unemployable/Golf-Mk5-RCD330-CAN-Filter/Ghidra/README.md

# Golf Mk5 RCD330 CAN Filter - Ghidra Reverse Engineering Files #
## Chinese CAN Filter Black Box ##

These devices only seem to be available as part of an adapter cable.<BR>
I've found at least two versions, with only minor differences in the code.

Included files are an original dumped binary, Ghidra zip file (gzf) & an export of the decompiled 'C' code.
  
It makes use of Thomas Roth's excellent Ghidra SVD-Loader scripts.

This is my first, amateur attempt to decompile an STM32 binary.<BR>
I have tried to include lots of comments to assist with my understanding of the code.

The most interesting function is the CAN interrupt routine *FUN_CAN_INT_MAIN_080004d8()*, where the message filtering takes place.<BR>
If no CAN msgs are received, it will trigger the IWDG watchdog timeout, which causes a reset and it will immediately go into sleep/stop mode.<BR>
New CAN msgs will wake it up via an EXTI interrupt. See function *FUN_MAIN_LOOP_08000c68()* for the overall operation. 
  
It is far easier to navigate through the code when loaded into Ghidra via the gzf file.<BR>
The 'C' code is mostly structure definitions of the peripherals, but still helpful if you don't want to install Ghidra.

Note that these devices are not really CAN filters. They sit across the CAN bus listening for certain messages and then sending additional, modified versions.
