unemployable/Golf-Mk5-RCD330-CAN-Filter/Core/README.md

# Golf Mk5 RCD300 CAN Filter - Source Code #
This was compiled using STM32CubeIDE v1.8

Note that the linker script was modified to enable storage of non-volatile variables in SRAM (.noinit).<BR>
I've included the ioc, ld and bin files in the main directory.
