unemployable/Golf-Mk5-RCD330-CAN-Filter/(threads)

Thread 1 (2023-05-25):

enhancement: Register the filter as a radio in MFD

binginsin, 2023-05-25:
Hey!

Very interesting project. I have in the past created an arduino module that registers itself as a phone on the MFD/CANBUS and can display it's own MFD screen with text and then react to button clicks that are sent specifically to it.

I was thinking you could use/examine my code to enhance your filter.

If your filter registered as a Radio on startup and register it's own menu, it then could respond to up/down arrows only when they are actually sent to the radio, instead of always responding to them.

My repository and arduino code is in:
https://github.com/binginsin/VW-TP-1.6-CANBUS-Radio-Sim

Unfortunately I didn't write up any information about the boards I used, but I remember it was a simple arduino that was being connected to a custom CANBUS board over SPI, so perhaps not too different from your code. Either way, what matters is the TP 1.6 protocol not which libraries are used.

If you check the Functions.ino, there is a method called AddMainMenu which registers with the MFD and adds a new section that can be swapped into with the menu button.
DisplaySingleTrack writes some text on the screen, DecodeFrame takes in incoming CAN messages and then acts on them if they were sent to us. This includes displaying the text in the screen when the Radio menu is entered as well as responding to button up/down presses.

I'm not sure if you are still working on this project but I thought I'd share this.

I would love to be able to control my songs on RCD330 from the steering wheel without changing the screens on MFD. Displaying the track would be nice but would probably be quite difficult to decode that information coming from RCD330.

unemployable, 2023-05-28:
Thanks for the message, I will definitely have a look at your TP 1.6 code.
Hopefully I can figure out a way to use it in this project.

Unfortunately, my latest v3 cable failed over summer and now only works randomly.
I am tired of pulling the dash apart and lost the motivation to fix it.

This might be just what I needed to get back into it...

Thread 2 (2024-03-03):

How to make this useable?

zCruuz, 2024-03-03:
As far as I understood I'll need to buy
-blue board
-ftdi adapter board for flashing
-rcd can adapter

Then I use the ftdi board to flash the dump using uart mode.
How to correctly wire this and setup for flashing atm is beyond my understanding

unemployable, 2024-03-03:
The latest green boards need serial FTDI for flashing, the blue boards need an ST-Link V2 SWD programmer as shown in this video:
[https://www.youtube.com/watch?v=NAWpqNjOGlc](https://www.youtube.com/watch?v=NAWpqNjOGlc)

The blue board's SWD header is in the top right corner of this picture (SWDIO, SWCLK etc):
[https://dangerouspayload.files.wordpress.com/2020/03/dsc_6293-2-copy.jpg?w=1024](https://dangerouspayload.files.wordpress.com/2020/03/dsc_6293-2-copy.jpg?w=1024)

Before getting the RCD330, I didn't know anything about STM32 programming, so I started out using a couple of "Black Pill" boards with separate CAN interfaces (as described in the original forum by [MrPanini](https://oshwlab.com/Mrpanini/canbus6))

I'd recommend getting one of the common STM32 devel boards & an ST-Link V2 to get the hang of it.
There are lots of tutorials available to help get started.

zCruuz, 2024-08-13:
So i was able to flash the can filter, now i need to connect it to the Quadlock connector.
Now i got two questions
The first is, i don't understand which can wires of the filter need to connect to the orange and white cable?
or is it meant like filter can1 "can in" and filter can 2 "can out" so the whole can is looped through the board?

the second is about the links between solder pads does this mean the two i marked on the picture?
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

unemployable, 2024-08-14:
Regarding the solder pads, yes your picture shows them correctly.
There is a small track between them which means the board has 120 ohm terminating resistors connected.
These are needed for standalone testing, but when installed the tracks need to be cut (apparently the vehicle & radio already have them).

Yeah, I also wasn't very clear on which CAN interface connects to where.

The blue board is acting like a Man-in-the-Middle attack.
One CAN interface talks just to the vehicle, the other just to the radio
(i.e. we cut the direct vehicle/radio CAN connection on the quadlock cable).

Each CAN interface is both sending and receiving CAN messages, most of them passing unchanged between them (i.e. CAN1 Rx => CAN2 Tx & CAN2 Rx => CAN1 Tx).
However, the s/w detects and modifies particular messages allowing the RCD330 to understand certain Golf MK5 messages.

From comments in the code, which is a bit more specific:

	// STM32 Cabling and CAN connections to the RCD330 Quadlock Wiring Harness (steering button adaptor)
	//
	// On the Blue (SWD) Dual Filter Board:
	// (Note: this matches the "new" green board)
	//
	// CAN1 is the RCD330
	// 	GREEN	CAN High
	//	PURPLE	CAN Low

	// CAN2 is the Vehicle
	// 	BLUE	CAN High
	//	YELLOW	CAN Low

	// PQ Quadlock connector (cheap one)
	//	Green	CAN High
	//	Purple	CAN Low
	// 	YELLOW	12V Battery
	//	BLACK	GND

	// Strategy:
	//	Cut the CAN High/Low connections between the connectors, midway.
	//	Connect the appropriate sides to the Blue CAN board
	//	Note: RCD330 side has the lever connector (female pins), the vehicle is the plain connector (male pins).
	//  Cut the thin YELLOW and BLACK wires (power) that used to go to the original black box.
	//  Tap the Blue boards power into these and re-connect them all together.

Looks like your blue board uses the same colours, your quadlock colours may not match.
All three of mine have different colours going between the plugs.
It is best to reference everything back to the qualock pinout diagram.

The wires going to the original CAN filter module (which needs to be removed), are probably the white/orange ones?
These will be joined with other wires on one of the quadlock plugs (i.e. the direct CAN connections between each end).
Probably simpler to ignore these extra white/orange filter module CAN wires and just use the ones that were directly connected between the plugs (i.e. the ones cut in the middle).

Thread 3 (2025-04-18):

Reverse Engineered Code

virtualwebber, 2025-04-18:
I am came across this whilst looked for a solution for running an RCD330 in an old 2006 Transporter. The Chinese adapter you mention seems to work in my vehicle apart from it turns on and off the illumination of the head unit every 30 seconds. I notice you have reverse engineered the device code. Is it possible from what you saw to modify any of the code to disable sending illumination signals and can it be modified and written back to the original device? In fact all I need the device to do is modify the button messages. Anything else like the wake up etc can be removed (as I have another CANBUS decoder that sorts all that out).

unemployable, 2025-04-28:
It sounds like the Transporter is behaving exactly like the Golf and sending the wrong brightness values to the RCD330.

I didn't find any code that was detecting/sending illumination messages, just the 3 documented (Watchdog, Buttons & Power).
It could be that there is a new version that has added them.  In that case, it would probably cause the issue you are experiencing.  Does it still occur with just the other CANBUS decoder connected?

In the [forum](https://rcd330plus.com/showthread.php?tid=6741) (which now needs registration to view), there was some discussion about trying to use other available CANBUS decoders to fix the issue, some of which would also cause the changing illumination problem.  Which CANBUS decoder are you using to fix the wake up issue?

The conclusion was that the only working solution was to break the RCD330 CANBUS in order to filter/modify incorrect messages.

virtualwebber, 2025-04-29:
No once removed the other one worked fine. Thanks for the link, not sure that forum exists any longer as I had tried to register a while back to it and never got anywhere. I have managed to find another solution to the issue now that doesn't need the MFSW decoder and have gone down this route for the moment. It uses a LIN-2-CAN adapter https://lavky.com/home-and-living/everything-else/auto-parts/steering-wheel-adapter-converter/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 . I still need the CAN Bus decoder for power etc, but for the buttons the adapter sends native commands to the head unit, eliminating the need for the converter decoder.

virtualwebber, 2025-04-30:
I probably wasn't 100% clear in my explanation of my setup :). My vehicle doesn't have any CANBUS on the Radio side. There is 1.6 on the cluster, but that is it. I am using a fairly modern steering wheel and already have the Lin-2-Can adapter in place to convert the LIN signals to what I had before the RCD330, which was a Pioneer head unit. On switching the head unit to the RCD330 I needed this decoder [Can Bus Emulator](https://vi.aliexpress.com/item/4000149218274.html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) for it support basic functions around powering on/off correctly, illumination and reverse camera (as my vehicle has no CAN 2 etc). I had configured the Lin-2-Can adapter to convert the LIN Signals to CAN (rather than what Pioneer), but that couldn't control the RDC330. I connected an MSFW decoder and that must have been converting the signals from the Lin-2-Can adapter to what the RCD330 understands, just I was getting the illumination happening on and off with the MSFW decoder connected. I am working with the creator of the Lin-2-Can adapter to now send native RCD330 CAN signals and so far testing is going well and the MSFW is no longer needed.

On that CAN to USB Analyser what software are you using?

unemployable, 2025-04-30:
Thanks for clarifying - quite a bit different to anything I've done.

I've been using CANPro s/w, I think it came with the unit.
It was good for sending message sequences on one CAN port while receiving on the other.
Very useful to check if the filter was doing the right thing during development.
