unemployable/Golf-Mk5-RCD330-CAN-Filter/Green Dual Can Bus - STM32F107 Serial.ioc

Mcu.UserName=STM32F107RBTx
PA0-WKUP.Signal=ADCx_IN0
PA10.Signal=USART1_RX
PA11.Signal=CAN1_RX
PA12.Signal=CAN1_TX
PA13.Signal=SYS_JTMS-SWDIO
PA14.Signal=SYS_JTCK-SWCLK
PA9.Signal=USART1_TX
PB13.Signal=GPXTI13
PB14.Signal=GPXTI14
PB15.Signal=GPXTI15
PB5.Signal=CAN2_RX
PB6.Signal=CAN2_TX
PB9.GPIO_Label=LED
PB9.Signal=GPIO_Output
PD0-OSC_IN.Signal=RCC_OSC_IN
PD1-OSC_OUT.Signal=RCC_OSC_OUT
