unemployable/Golf-Mk5-RCD330-CAN-Filter/(commit log)

2022-04-13 Update Chinese CAN Filter.bin.c
2022-04-16 Revert "Add files via upload"
    This reverts commit e35e7db535af1b0b9a14e0629a9c5e55ad6ea409.
    [main.c]
2022-04-16 Revert "Revert "Add files via upload""
    This reverts commit 18eb1a0bf3bf69b0db2be058d37ed7d7ae0e0e01.
    [main.c]
2022-04-16 Revert "Delete STM32F105RBTX_FLASH.ld"
    This reverts commit 071f4c5e00ff5d5c08ee801615fdf6037ec5656b.
2022-04-16 Revert "Delete Blue Dual Can Bus Board.bin"
    This reverts commit 1d6c96c110b5f40f4f2e149d04b077d655fc9785.
2022-04-16 Revert "Delete Blue Dual Can Bus Board.ioc"
    This reverts commit 7d59d2ca736e9225c913942cee97872d45704ae9.
